BioMakers/14_Self-regulating-Drug-Delivery/Hardware/Microfluidic Chip/electrode-template-v1.odt

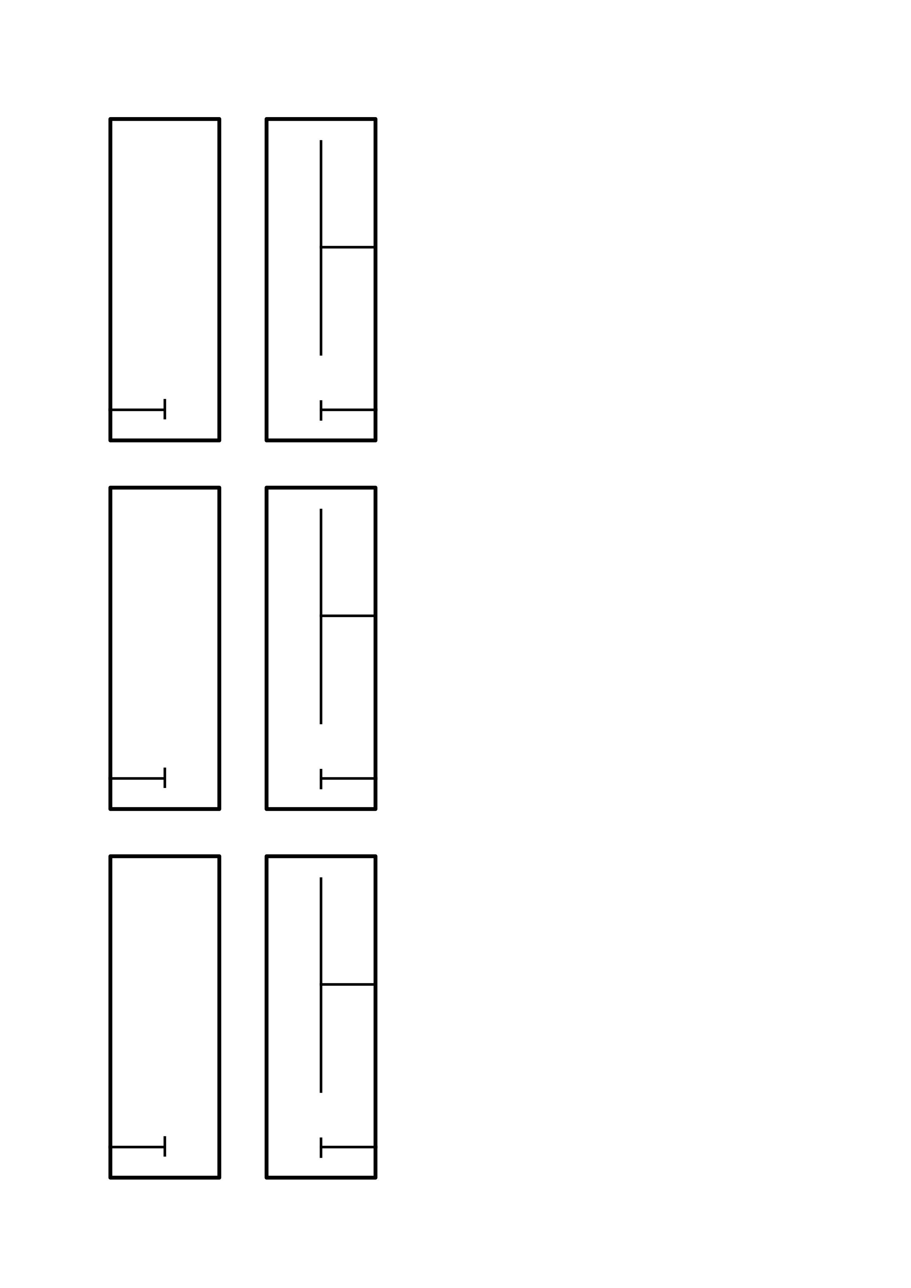
[picture p21: figure]
