BioMakers/14_Self-regulating-Drug-Delivery/Hardware/Infusion Pump/pump-prototype2.jpeg

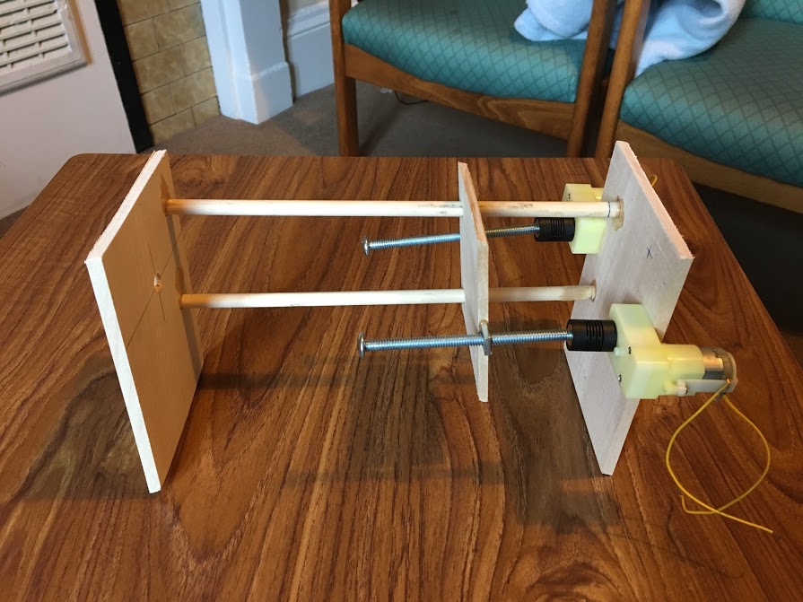
Hardware/Infusion Pump/pump-prototype2.jpeg
