BioMakers/14_Self-regulating-Drug-Delivery/Images/7-Au-Aptamer.png

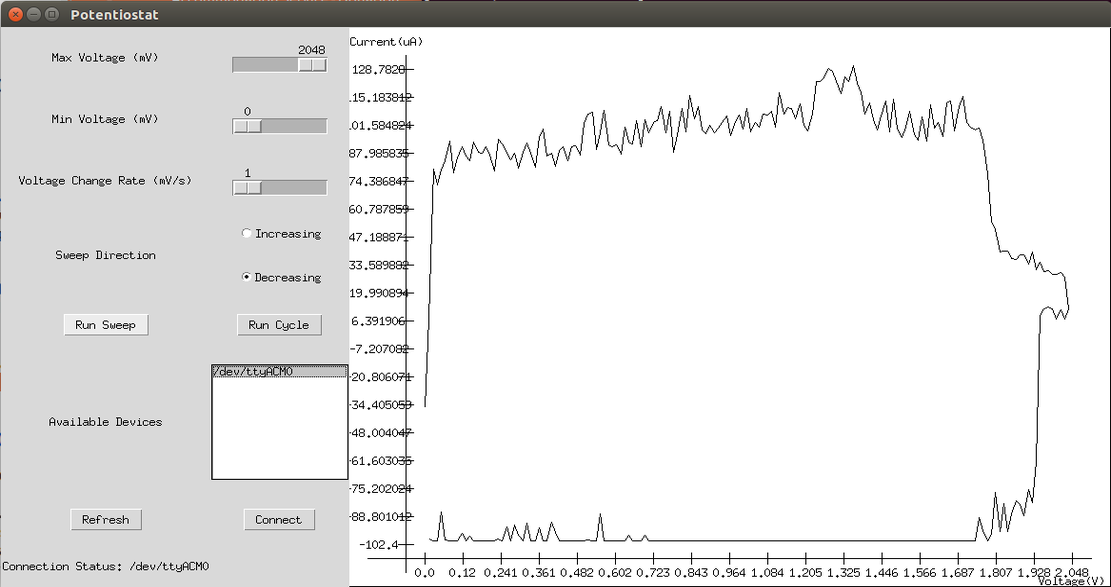
Images/7-Au-Aptamer.png
