BioMakers/14_Self-regulating-Drug-Delivery/Images/15-Au-aptamer.png

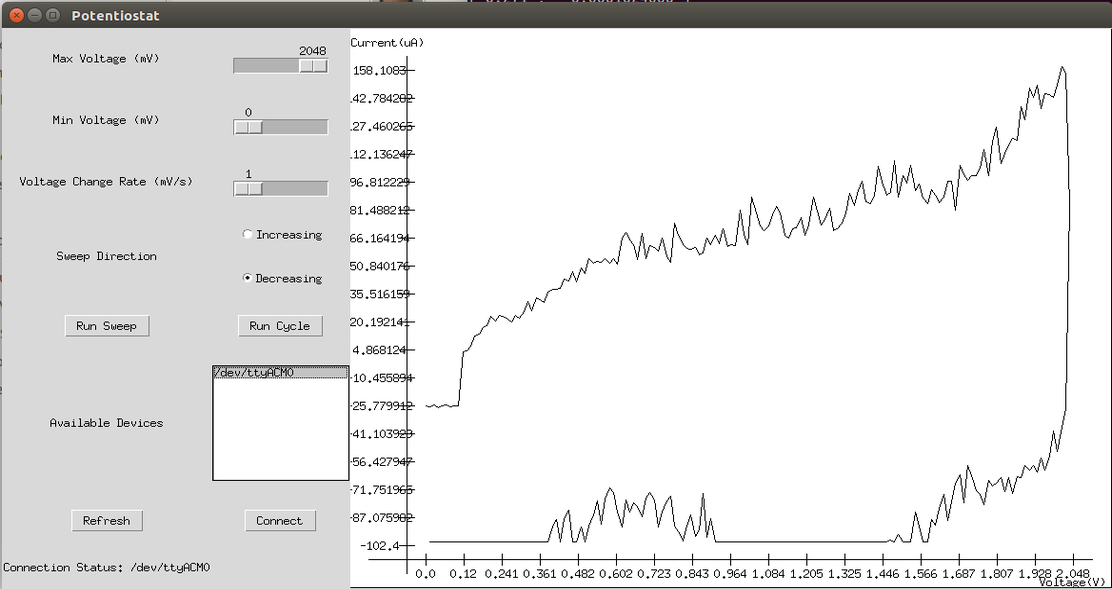
Images/15-Au-aptamer.png
