BioMakers/14_Self-regulating-Drug-Delivery/Images/PBS-Au-Aptamer-2.png

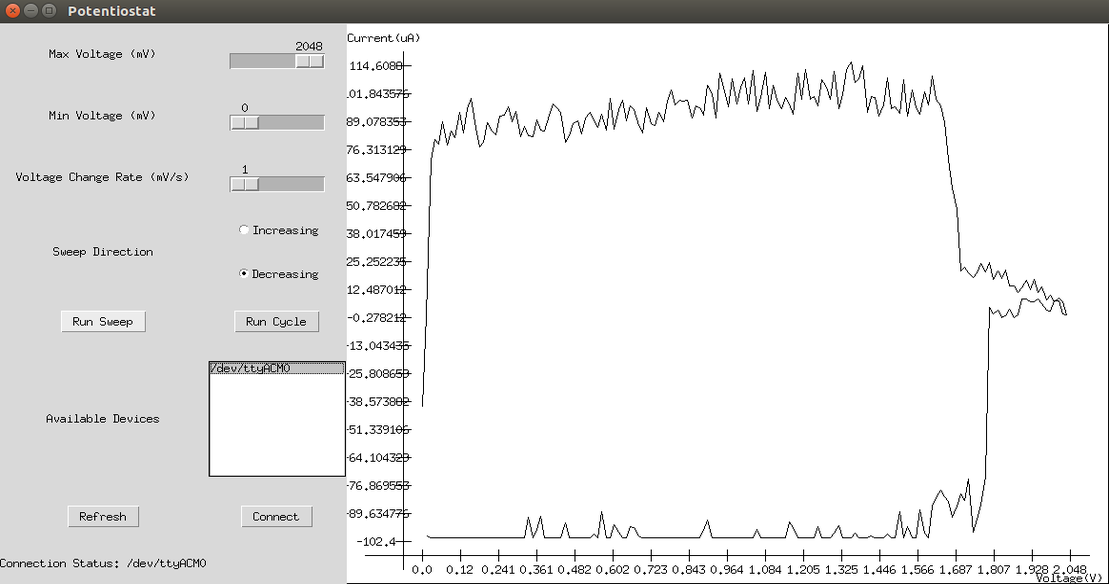
Images/PBS-Au-Aptamer-2.png
