BioMakers/14_Self-regulating-Drug-Delivery/Images/ProgressUpdate24Aug2017.jpeg

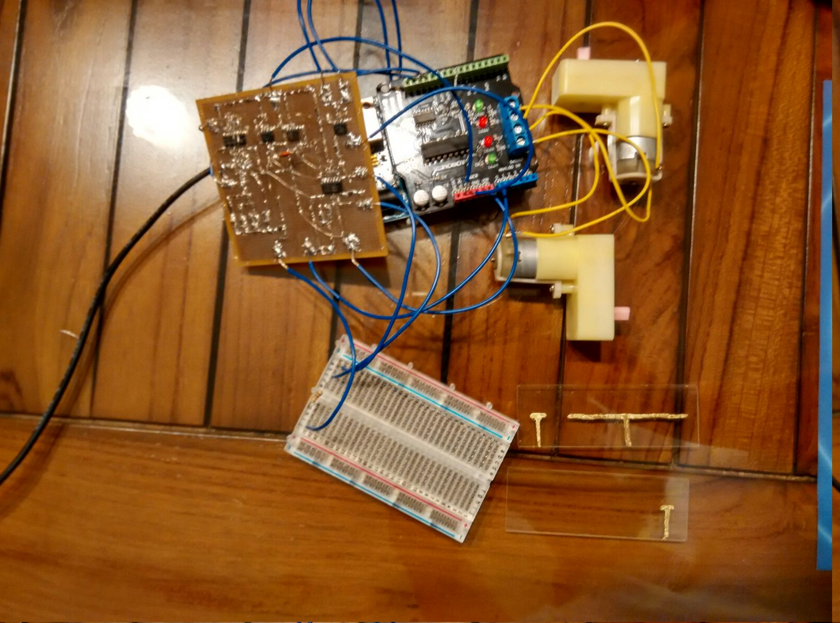
Images/ProgressUpdate24Aug2017.jpeg
