BioMakers/14_Self-regulating-Drug-Delivery/Software/VdperKgDiscrepancy.png

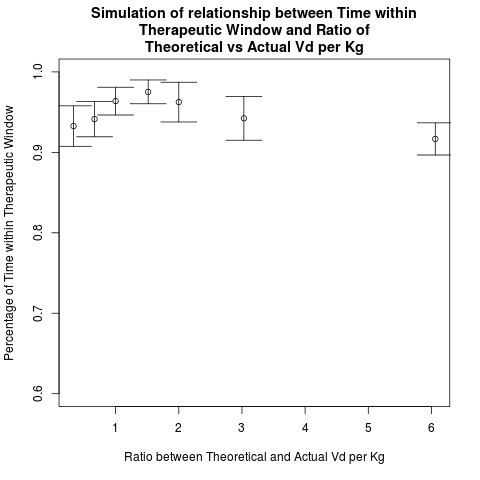
Software/VdperKgDiscrepancy.png
