BioMakers/14_Self-regulating-Drug-Delivery/Software/WindowSizeSignalNoiseRelationship.png

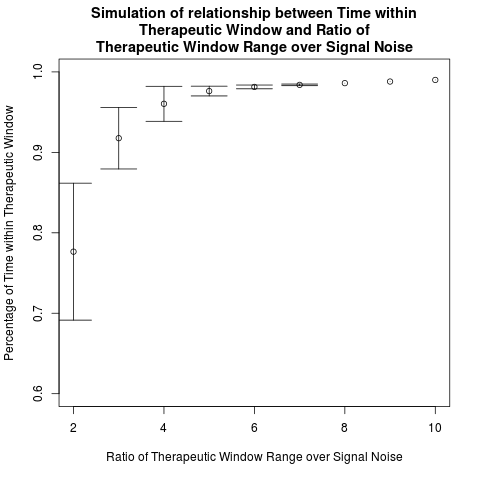
Software/WindowSizeSignalNoiseRelationship.png
