BioMakers/14_Self-regulating-Drug-Delivery/(commit log)

2017-08-24 Progress Update: *Potentiostat circuit implemented and being tested/worked on, still a bit noisy and not sure if working properly across all ranges of voltage *Prototype of infusion pump built, issue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
    [potentiostat-pump-controller.ino]
2017-08-24 modified potentiostat circuit changed DAC ref from 1.024V to 3.3V
2017-08-24 fixed sallen key lowpass filter by adding 10nF capacitor and updated schematics and image
2017-08-25 wrote up some rudimentary software for the arduino uno to control the potentiostat linear sweep and a desktop GUI to control and view
2017-09-03 switched to using R for simulation
